zosko/YMFC-32/YMFC-32-kicad/YMFC-32.kicad_pcb

## KiCad design YMFC-32-kicad/YMFC-32.kicad_pcb (2022-04-20)

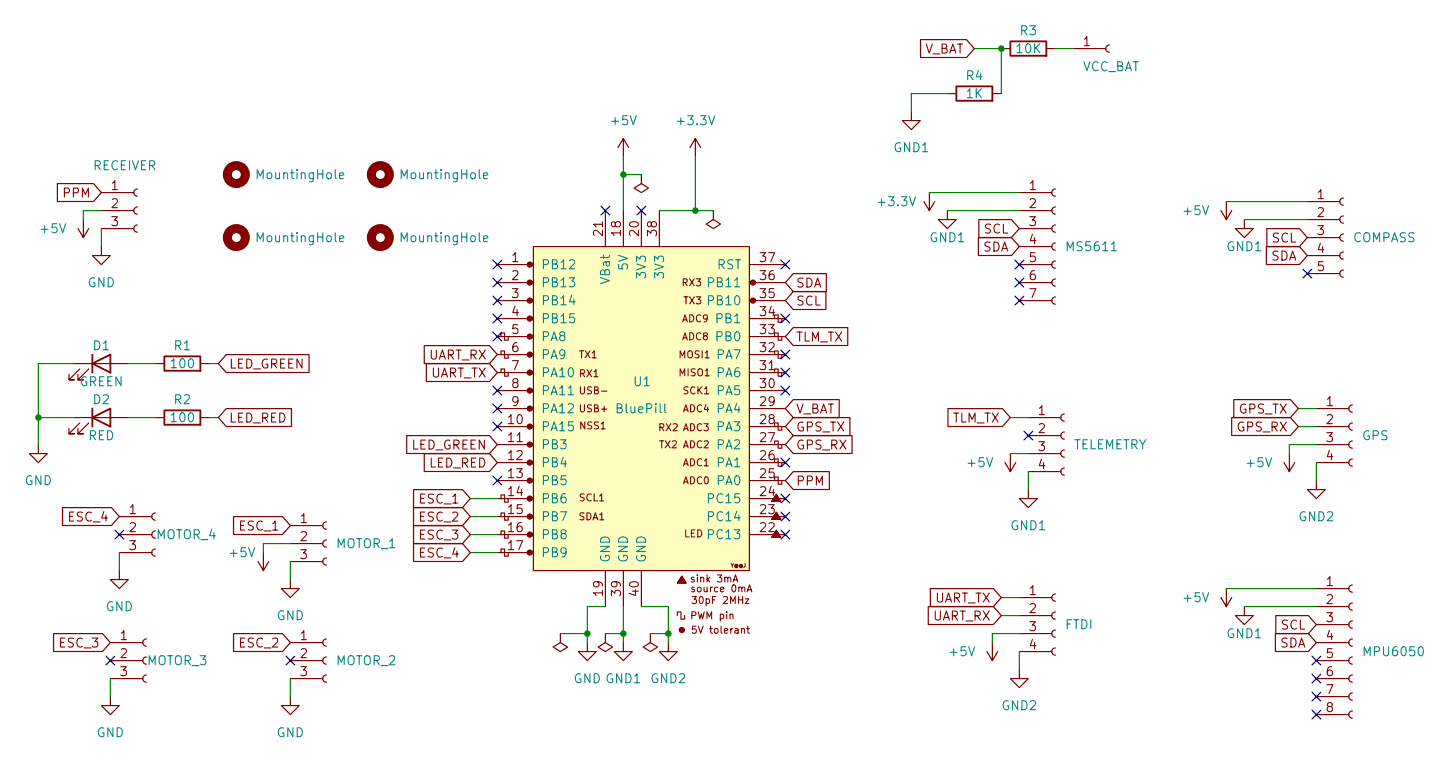
[picture p6: schematic YMFC-32.kicad_sch]

Parts:
D1: GREEN; LED_D5.0mm
D2: RED; LED_D5.0mm
H1, H2, H3, H4: MountingHole; MountingHole_3mm
J1: RECEIVER; PinHeader_1x03_P2.54mm_Vertical
J2: MOTOR_1; PinHeader_1x03_P2.54mm_Vertical
J3: MOTOR_2; PinHeader_1x03_P2.54mm_Vertical
J4: MOTOR_3; PinHeader_1x03_P2.54mm_Vertical
J5: MOTOR_4; PinHeader_1x03_P2.54mm_Vertical
J6: VCC_BAT; TestPoint_Pad_4.0x4.0mm
J7: TELEMETRY; PinHeader_1x04_P2.54mm_Vertical
J8: FTDI; PinHeader_1x04_P2.54mm_Vertical
J9: GPS; PinHeader_1x04_P2.54mm_Vertical
J10: MPU6050; PinHeader_1x08_P2.54mm_Vertical
J11: MS5611; PinHeader_1x07_P2.54mm_Vertical
J12: COMPASS; PinHeader_1x05_P2.54mm_Vertical
R1, R2: 100; R_Axial_DIN0309_L9.0mm_D3.2mm_P12.70mm_Horizontal
R3: 10K; R_Axial_DIN0309_L9.0mm_D3.2mm_P12.70mm_Horizontal
R4: 1K; R_Axial_DIN0309_L9.0mm_D3.2mm_P12.70mm_Horizontal
U1: BluePill; YAAJ_BluePill_1

Connections:
+3V3: J11.1, U1.38 (3V3)
+5V: J1.2, J2.2, J7.3, J8.3, J9.3, J10.1, J12.1, U1.18 (5V)
ESC_1: J2.1, U1.14 (PB6)
ESC_2: J3.1, U1.15 (PB7)
ESC_3: J4.1, U1.16 (PB8)
ESC_4: J5.1, U1.17 (PB9)
GND: D1.1 (K), D2.1 (K), J1.3, J2.3, J3.3, J4.3, J5.3, U1.19 (GND)
GND1: J7.4, J10.2, J11.2, J12.2, R4.1, U1.39 (GND)
GND2: J8.4, J9.4, U1.40 (GND)
GPS_RX: J9.2, U1.27 (PA2)
GPS_TX: J9.1, U1.28 (PA3)
LED_GREEN: R1.2, U1.11 (PB3)
LED_RED: R2.2, U1.12 (PB4)
unnamed: D1.2 (A), R1.1
unnamed: D2.2 (A), R2.1
unnamed: J6.1, R3.2
PPM: J1.1, U1.25 (PA0)
SCL: J10.3, J11.3, J12.3, U1.35 (PB10)
SDA: J10.4, J11.4, J12.4, U1.36 (PB11)
TLM_TX: J7.1, U1.33 (PB0)
UART_RX: J8.2, U1.6 (PA9)
UART_TX: J8.1, U1.7 (PA10)
V_BAT: R3.1, R4.2, U1.29 (PA4)

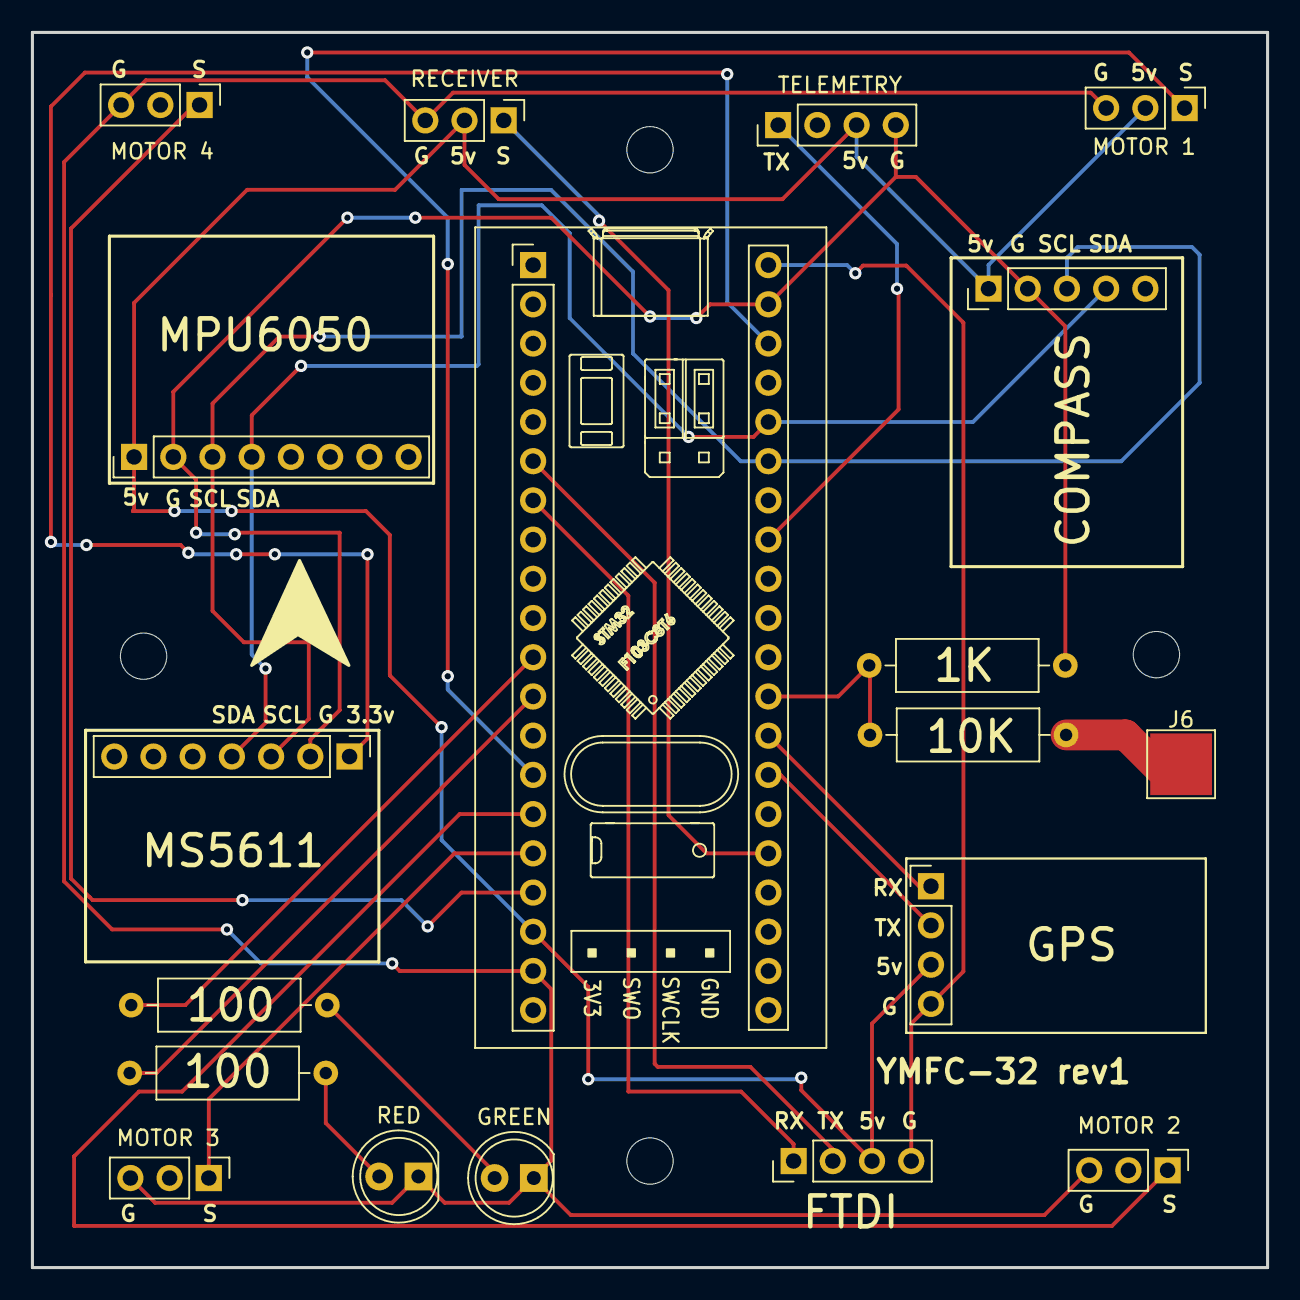
[picture p7: board YMFC-32.kicad_pcb from above]

Board: 2 copper layers, 80.0 x 80.0 mm, 23 parts (0 on the bottom side), 23 nets.
