zosko/YMFC-32/(commit log)

2022-02-26 add stm32 library
2022-02-26 add kicad
    [YMFC-32-B_Cu.gbr, YMFC-32-B_Mask.gbr, YMFC-32-B_Paste.gbr, YMFC-32-B_Silkscreen.gbr, YMFC-32-Edge_Cuts.gbr, YMFC-32-F_Cu.gbr, YMFC-32-F_Mask.gbr, YMFC-32-F_Paste.gbr]
2022-02-26 add gerber files
2022-02-27 clean files
    [YMFC-32-B_Cu.gbr, YMFC-32-B_Mask.gbr, YMFC-32-B_Paste.gbr, YMFC-32-B_Silkscreen.gbr, YMFC-32-Edge_Cuts.gbr, YMFC-32-F_Cu.gbr, YMFC-32-F_Mask.gbr, YMFC-32-F_Paste.gbr]
